tdav260/NotSoSmartWatch/Hardware/Basic/Bottom/NotSoSmartWatch-BASIC-BOTTOM-BOM.xlsx

NotSoSmartWatch Bottom Board -- Rev A / Thomas Davis |  |  |  |  |  |  |  |  |  |  | Total | $20.04 | Total (in Bulk) | $0.00
BOM # | Comment | Designator | Description | Mounting Type | Package | Manufacturer | Manufacturer Part Number | Supplier | Supplier Part Number | Price per unit | Quantity | Total | Per 100 | Total
 | DigiKey
1 | Real-Time Clock | RTC | Real Time Clock (RTC) IC Clock/Calendar I²C, 2-Wire Serial 8-SOIC (0.154", 3.90mm Width) | SMD | 8-SO | NXP USA Inc. | PCF8523T/1,118 | Digi-Key | 568-5306-1-ND | $1.26 | 1 | $1.26
2 | 32.768 kHz Crystal | XTAL2 | 32.768kHz ±10ppm Crystal 12.5pF 90 kOhms 2-SMD, No Lead | SMD | 2-SMD, No Lead | ECS Inc. | ECS-.327-12.5-12-C-TR | Digi-Key | XC2288CT-ND | $0.60 | 1 | $0.60
3 | AD5242 | U1 | Digital Potentiometer 1M Ohm 2 Circuit 256 Taps I²C Interface 16-SOIC | SMD | 16-SOIC | Analog Devices Inc. | AD5242BRZ1M | Digi-Key | AD5242BRZ1M-ND | $3.47 | 1 | $3.47
4 | CONN_07-1.27MM (CONN_07) | J1 | 50 Position Header Connector 0.050" (1.27mm) Through Hole Gold | THT |  | Sullins Connector Solutions | LPPB501NFFN-RC | Digi-Key | S9008E-50-ND | $5.06 | 1 | $5.06
5 | NPN-Generic | Q1 | Bipolar (BJT) Transistor NPN 40V 600mA 300MHz 250mW Surface Mount TO-236AB | SMD | TO-236AB | Nexperia USA Inc. | PMBT2222A,215 | Digi-Key | 1727-2956-1-ND | $1.05 | 1 | $1.05
6 | 100 nF Capacitor | C1, C2, C10, C11, C17, C18, C22 | 0.1µF ±5% 16V Ceramic Capacitor X7R 0603 (1608 Metric) | SMD | 0603 | Yageo | CC0603JRX7R7BB104 | Digi-Key | 311-1776-1-ND | $0.03 | 7 | $0.23
7 | 10k ohm Resistor | R17, R18, R24 | 10 kOhms ±1% 0.1W, 1/10W Chip Resistor 0603 (1608 Metric) Automotive AEC-Q200 Thick Film | SMD | 0603 | Stackpole Electronics Inc | RMCF0603FT10K0 | Digi-Key | RMCF0603FT10K0CT-ND | $0.01 | 3 | $0.02
8 | 1 uF Capacitor | C3 | 1µF ±10% 25V Ceramic Capacitor X5R 0603 (1608 Metric) | SMD | 0603 | Samsung Electro-Mechanics | CL10A105KA8NNNC | Digi-Key | 1276-1102-1-ND | $0.10 | 1 | $0.10
9 | CONN_07-1.27MM | G$1 | 50 Positions Header Connector 0.050" (1.27mm) Through Hole Gold | THT |  | Sullins Connector Solutions | GRPB501VWVN-RC | Digi-Key | S9014E-50-ND | $3.11 | 1 | $3.11
10 | 2.2 uF Capacitor | C14, C15, C16, C19 | 2.2µF ±10% 16V Ceramic Capacitor X5R 0603 (1608 Metric) | SMD | 0603 | Samsung Electro-Mechanics | CL10A225KO8NNNC | Digi-Key | 1276-1040-1-ND | $0.03 | 4 | $0.13
11 | 220k ohm Resistor | R13, R15, R19, R21 | 220 kOhms ±1% 0.1W, 1/10W Chip Resistor 0603 (1608 Metric) Automotive AEC-Q200 Thick Film | SMD | 0603 | Stackpole Electronics Inc | RMCF0603FT220K | Digi-Key | RMCF0603FT220KCT-ND | $0.01 | 4 | $0.02
12 | 10M ohm Resistor | R14, R22 | 10 MOhms ±1% 0.1W, 1/10W Chip Resistor 0603 (1608 Metric) Automotive AEC-Q200 Thick Film | SMD | 0603 | Stackpole Electronics Inc | RMCF0603FT10M0 | Digi-Key | RMCF0603FT10M0CT-ND | $0.01 | 2 | $0.02
13 | 1M ohm Resistor | R20, R23 | 1 MOhms ±1% 0.1W, 1/10W Chip Resistor 0603 (1608 Metric) Automotive AEC-Q200 Thick Film | SMD | 0603 | Stackpole Electronics Inc | RMCF0603FT1M00 | Digi-Key | RMCF0603FT1M00CT-ND | $0.01 | 2 | $0.01
14 | 22 uF Capacitor | C20 | 22µF ±20% 10V Ceramic Capacitor X5R 0603 (1608 Metric) | SMD | 0603 | Samsung Electro-Mechanics | CL10A226MP8NUNE | Digi-Key | 1276-1274-1-ND | $0.07 | 1 | $0.07
15 | 22 nF Capacitor | C21 | 0.022µF ±10% 50V Ceramic Capacitor X7R 0603 (1608 Metric) | SMD | 0603 | Samsung Electro-Mechanics | CL10B223KB8NNNC | Digi-Key | 1276-1104-1-ND | $0.02 | 1 | $0.02
16 | Op Amp | OP3$G1, OP3$G2, OP3$G3, OP3$G4, OP4$G1 | General Purpose Amplifier 4 Circuit Rail-to-Rail 14-SOIC | SMD | 14-SOIC | Microchip Technology | MCP6004T-I/SL | Digi-Key | MCP6004T-I/SLCT-ND | $0.44 | 5 | $2.20
 | Mouser
1 | AD5171 | U$4 | Digital Potentiometer ICs IC 6-Bit OTP I2C | SMD | SOT-23-8 | Analog Devices | AD5171BRJZ100-R7 | Mouser | 584-AD5171BRJZ100-R7 | $2.68 | 1 | $2.68 |  | $0.00
 | Custom Order
1 | LSM6DS3 castellated breakout | IMU1 |  |  |  |  |  |  |  |  |  | $0.00
