tdav260/NotSoSmartWatch/Hardware/Basic/Top/NotSoSmartWatch-BASIC-TOP-BOM.xlsx

NotSoSmartWatch Top Board -- Rev A / Thomas Davis |  |  |  |  |  |  |  |  |  |  | Total | $29.83 | Total (in Bulk) | $0.00
BOM # | Comment | Designator | Description | Mounting Type | Package | Manufacturer | Manufacturer Part Number | Supplier | Supplier Part Number | Price per unit | Quantity | Total | Per 100 | Total
 | DigiKey
1 | Microcontroller | U1 | Bluetooth Bluetooth v4.2 Transceiver Module 2.4GHz Integrated, Chip Surface Mount | SMD | 41-SMD Module | Seeed Technology Co., Ltd | 317030213 | Digi-Key | 1597-1434-ND | $10.10 | 1 | $10.10
2 | FTDI | FTDI | USB Bridge, USB to UART USB 2.0 UART Interface 20-SSOP | SMD | 20-SSOP | FTDI, Future Technology Devices International Ltd | FT231XS-U | Digi-Key | 768-1156-5-ND | $2.12 | 1 | $2.12
3 | USB Interface | USB1 | USB - micro B USB 2.0 Receptacle Connector 5 Position Surface Mount, Right Angle | SMD | Flange, Horizontal | Amphenol FCI | 10118192-0001LF | Digi-Key | 609-4613-1-ND | $0.43 | 1 | $0.43
4 | Battery Charger | CHRG | Charger IC Lithium-Ion/Polymer SOT-23-5 | SMD | SOT-23-5 | Microchip Technology | MCP73831T-2ACI/OT | Digi-Key | MCP73831T-2ACI/OTCT-ND | $0.56 | 1 | $0.56
5 | Voltage Regulator | LDO1 | Linear Voltage Regulator IC 1 Output 300mA SOT-23-5 | SMD | SOT23-5 | Microchip Technology | MIC5504-3.3YM5-TR | Digi-Key | 576-4764-1-ND | $0.11 | 1 | $0.11
6 | Bigger Button | SW3, SW4 | Tactile Switch SPST-NO Top Actuated Surface Mount | SMD | Gull Wing | C&K | PTS645SM43SMTR92 LFS | Digi-Key | CKN9112CT-ND | $0.25 | 2 | $0.50
7 | 390k ohm resistor | R15 | 390 kOhms ±1% 0.1W, 1/10W Chip Resistor 0603 (1608 Metric) Automotive AEC-Q200 Thick Film | SMD | 0603 | Stackpole Electronics Inc | RMCF0603FG390K | Digi-Key | RMCF0603FG390KCT-ND | $0.01 | 1 | $0.01
8 | Schottky Diode | D1, D2, D3 | Diode Schottky 30V 1.5A Surface Mount USC | SMD | USC | Toshiba Semiconductor and Storage | CUS15S30,H3F | Digi-Key | CUS15S30H3FCT-ND | $0.26 | 3 | $0.77
9 | 100 nF Capacitor | C11, C14 | 0.1µF ±5% 16V Ceramic Capacitor X7R 0603 (1608 Metric) | SMD | 0603 | Yageo | CC0603JRX7R7BB104 | Digi-Key | 311-1776-1-ND | $0.03 | 2 | $0.07
10 | 10k ohm Resistor | R1, R2, R6, R10, R13 | 10 kOhms ±1% 0.1W, 1/10W Chip Resistor 0603 (1608 Metric) Automotive AEC-Q200 Thick Film | SMD | 0603 | Stackpole Electronics Inc | RMCF0603FT10K0 | Digi-Key | RMCF0603FT10K0CT-ND | $0.01 | 5 | $0.03
11 | 2.2u capacitor | C16, C17, C18, C19, C20 | 2.2µF ±10% 16V Ceramic Capacitor X5R 0603 (1608 Metric) | SMD | 0603 | Samsung Electro-Mechanics | CL10A225KO8NNNC | Digi-Key | 1276-1040-1-ND | $0.03 | 5 | $0.16
12 | 10 uF 0603 Capacitor | C2, C15 | 10µF ±10% 10V Ceramic Capacitor X5R 0603 (1608 Metric) | SMD | 0603 | Murata Electronics | GRM188R61A106KE69J | Digi-Key | 490-14372-1-ND | $0.06 | 2 | $0.13
13 | 47 pF Capacitor | C12, C13 | 47pF ±5% 50V Ceramic Capacitor C0G, NP0 0603 (1608 Metric) | SMD | 0603 | Walsin Technology Corporation | 0603N470J500CT | Digi-Key | 1292-1528-1-ND | $0.01 | 2 | $0.02
14 | 27 ohm resistor | R11, R12 | 27 Ohms ±1% 0.1W, 1/10W Chip Resistor 0603 (1608 Metric) Automotive AEC-Q200 Thick Film | SMD | 0603 | Stackpole Electronics Inc | RMCF0603FT27R0 | Digi-Key | RMCF0603FT27R0CT-ND | $0.01 | 2 | $0.01
15 | 1k ohm Resistor | R4, R5, R14, R16 | 1 kOhms ±1% 0.1W, 1/10W Chip Resistor 0603 (1608 Metric) Automotive AEC-Q200 Thick Film | SMD | 0603 | Stackpole Electronics Inc | RMCF0603FT1K00 | Digi-Key | RMCF0603FT1K00CT-ND | $0.01 | 4 | $0.02
16 | Red LED | LED1, LED3 | Red 622nm LED Indication - Discrete 2.2V 0603 (1608 Metric) | SMD | 0603 | Inolux | IN-S63ATR | Digi-Key | 1830-1065-1-ND | $0.18 | 2 | $0.35
17 | Yellow LED | LED4 | Yellow 590nm LED Indication - Discrete 2V 0603 (1608 Metric) | SMD | 0603 | Wurth Electronics Inc. | 150060YS75000 | Digi-Key | 732-4981-1-ND | $0.14 | 1 | $0.14
18 | Blue LED | LED2 | Blue 470nm LED Indication - Discrete 3V 0603 (1608 Metric) | SMD | 0603 | Inolux | IN-S63AT5B | Digi-Key | 1830-1061-1-ND | $0.18 | 1 | $0.18
19 | 32.768 kHz Crystal | XTAL1 | 32.768kHz ±10ppm Crystal 12.5pF 90 kOhms 2-SMD, No Lead | SMD | 2-SMD, No Lead | ECS Inc. | ECS-.327-12.5-12-C-TR | Digi-Key | XC2288CT-ND | $0.60 | 1 | $0.60
20 | 12 pF Capacitor | C3, C4 | 12pF ±5% 50V Ceramic Capacitor C0G, NP0 0603 (1608 Metric) | SMD | 0603 | Walsin Technology Corporation | 0603N120J500CT | Digi-Key | 1292-1480-1-ND | $0.01 | 2 | $0.02
21 | Debugger | DEBUG1 | Connector Header Through Hole 10 position 0.050" (1.27mm) | THT | NA | Amphenol ICC (FCI) | 20021111-00010T4LF | Digi-Key | 609-3712-ND | $0.69 | 1 | $0.69
22 | 1 uF Capacitor | C1, C8, C9 | 1µF ±10% 25V Ceramic Capacitor X5R 0603 (1608 Metric) | SMD | 0603 | Samsung Electro-Mechanics | CL10A105KA8NNNC | Digi-Key | 1276-1102-1-ND | $0.10 | 3 | $0.30
23 | 10 uH Inductor | L1 | 10µH Shielded Multilayer Inductor 250mA 1.05Ohm 0603 (1608 Metric) | SMD | 0603 | TDK Corporation | MLZ1608M100WTD25 | Digi-Key | MLZ1608M100WTD25 | $0.22 | 1 | $0.22
24 | 4.7 uF Capacitor | C5, C7 | 4.7 uF ±10% 16V Ceramic Capacitor X5R 0603 (1608 Metric) | SMD | 0603 | Samsung Electro-Mechanics | CL10A475KO8NNNC | Digi-Key | 1276-1784-1-ND | $0.04 | 2 | $0.09
25 | 100k ohm Resistor | R3, R7, R8, R9 | 100 kOhms ±1% 0.1W, 1/10W Chip Resistor 0603 (1608 Metric) Automotive AEC-Q200 Thick Film | SMD | 0603 | Stackpole Electronics Inc | RMCF0603FT100K | Digi-Key | RMCF0603FT100KCT-ND | $0.01 | 4 | $0.02
26 | CONN_07-1.27MM (CONN_07) | J1 | 50 Position Header Connector 0.050" (1.27mm) Through Hole Gold | THT |  | Sullins Connector Solutions | LPPB501NFFN-RC | Digi-Key | S9008E-50-ND | $5.06 | 1 | $5.06
27 | Tiny Rectangular Switch | SW1, RESET | Tactile Switch SPST-NO Top Actuated Surface Mount | SMD | Gull Wing | C&K Components | PTS830GM140 SMTR LFS | Digi-Key | CKN10587CT-ND | $0.57 | 2 | $1.14
28 | 350 mAh LiPo Battery | J2 | 3.7V Lithium Polymer Battery Rechargeable (Secondary) 350mAh | JST | JST PH Connector | Adafruit Industries LLC | 4237 | Digi-Key | 1528-4237-ND | $5.95 | 1 | $5.95
29 | 0 ohm resistor (not sure if needed) | JP1, R17, R18 | 0 Ohms Jumper 0.1W, 1/10W Chip Resistor 0603 (1608 Metric) Moisture Resistant Thick Film | SMD | 603 | Yageo | RC0603JR-070RL | Digi-Key | 311-0.0GRCT-ND | $0.01 | 3 | $0.03
 | BuyDisplay.com
29 | OLED | U4 | Datasheet 128x64 OLED Module SPI 0.96"Graphic Displays,White on Black | SMD | Flexible Connector | EastRising | https://www.buydisplay.com/datasheet-128x64-oled-module-spi-0-96-inch-graphic-displays-white-on-black | BuyDisplay.com | https://www.buydisplay.com/datasheet-128x64-oled-module-spi-0-96-inch-graphic-displays-white-on-black | $2.51
