tdav260/NotSoSmartWatch/Hardware/Basic/PPG-Module/NotSoSmartWatch-BASIC-PPG-MODULE-BOM.xlsx

NotSoSmartWatch PPG Module -- Rev A / Thomas Davis |  |  |  |  |  |  |  |  |  |  | Total | $4.79 | Total (in Bulk) | $3.25
BOM # | Comment | Designator | Description | Mounting Type | Package | Manufacturer | Manufacturer Part Number | Supplier | Supplier Part Number | Price per unit | Quantity | Total | Per 100 | Total
1 | Photodiode | PD | Photodiode 940nm 100ns 130° 2-SMD, Gull Wing, PHOTODIODE PIN HI SPEED HI SENS | SMD | 2-SMD, Gull Wing | Vishay Semiconductor Opto Division | VBPW34S | Digi-Key | 751-1500-1-ND | $1.19 | 1 | $1.19 | $0.57 | $0.57
2 | Green LED | LED1 | Green 525nm LED Indication - Discrete 3.1V 0805 (2012 Metric) | SMD | 0805 | QT Brightek (QTB) | QBLP631-IG | Digi-Key | 1516-1084-1-ND | $0.39 | 1 | $0.39 | $0.16 | $0.16
3 | 2.2µF capacitor | 0603 | 2.2µF ±10% 10V Ceramic Capacitor X5R 0603 (1608 Metric) | SMD | 0603 | Samsung Electro-Mechanics | CL10A225KP8NNNC | Digi-Key | 1276-1085-1-ND | $0.10 | 1 | $0.10 | $0.03 | $0.03
4 | 0.05' spaced Header Pins | J1 | Connector Header Through Hole 50 position 0.050" (1.27mm) | THT | NA | Sullins Connector Solutions | GRPB501VWVN-RC | Digi-Key | S9014E-50-ND | $3.11 | 1 | $3.11 | $2.49 | $2.49
