tdav260/NotSoSmartWatch/Hardware/Basic/Top/NotSoSmartWatch-BASIC-TOP-version2.brd

## EAGLE design Hardware/Basic/Top/NotSoSmartWatch-BASIC-TOP-version2.brd (2021-03-20)

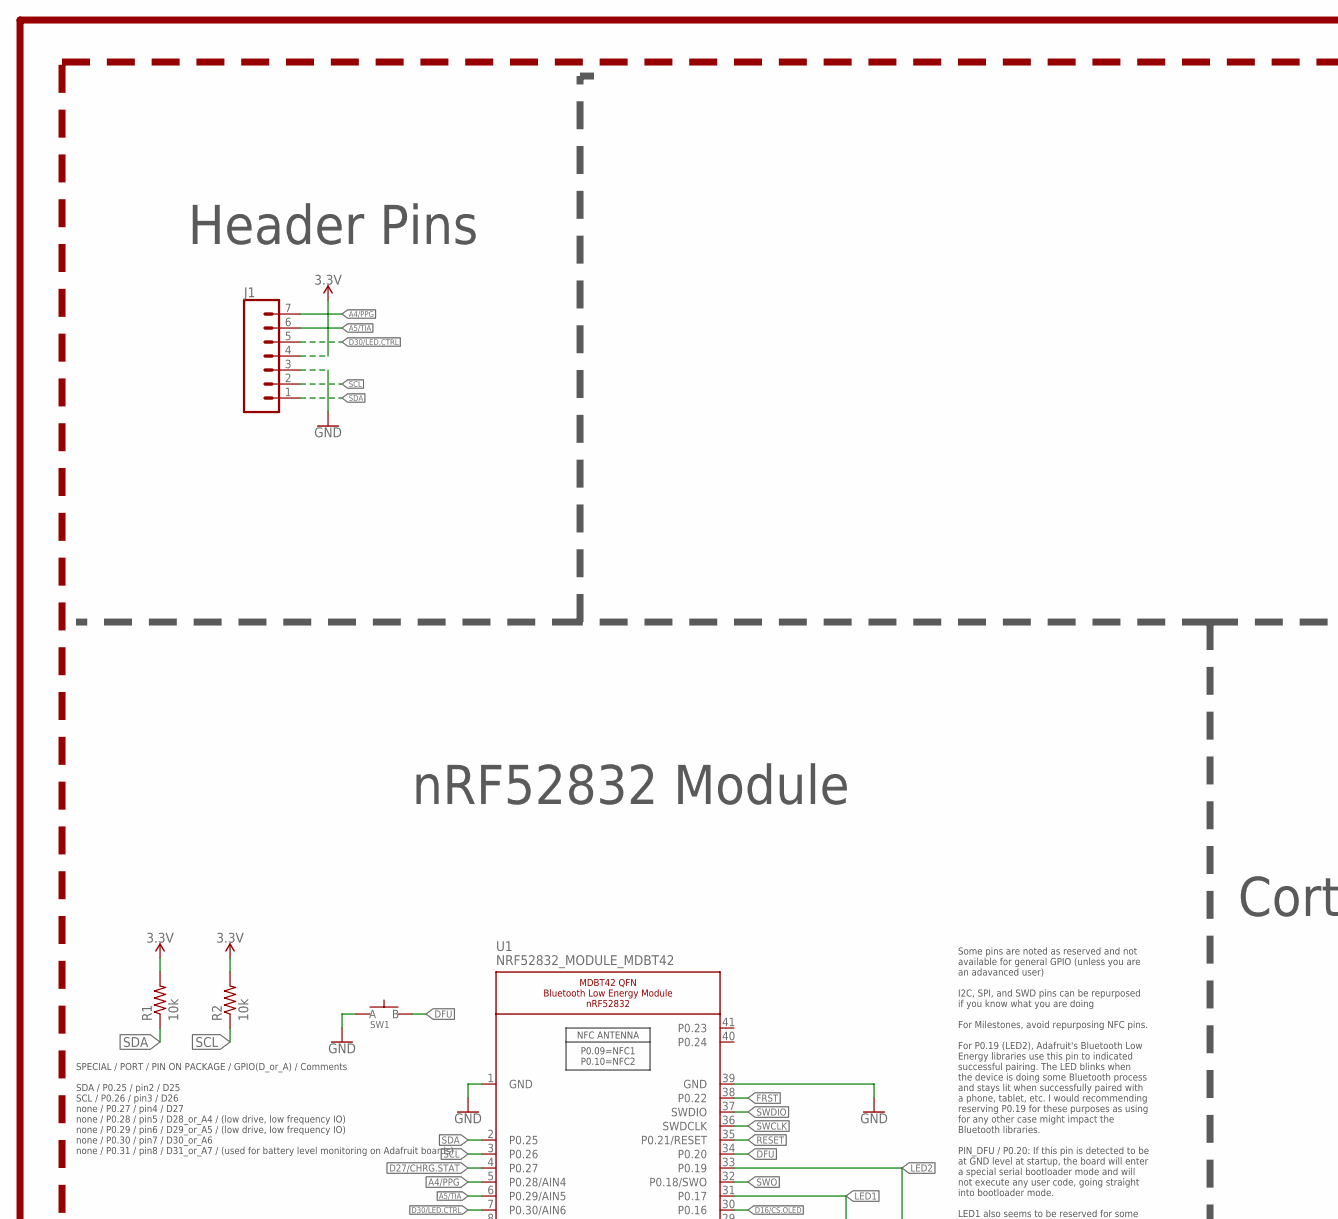
[picture p1: schematic NotSoSmartWatch-BASIC-TOP-version2.sch, part in row 1, column 1]

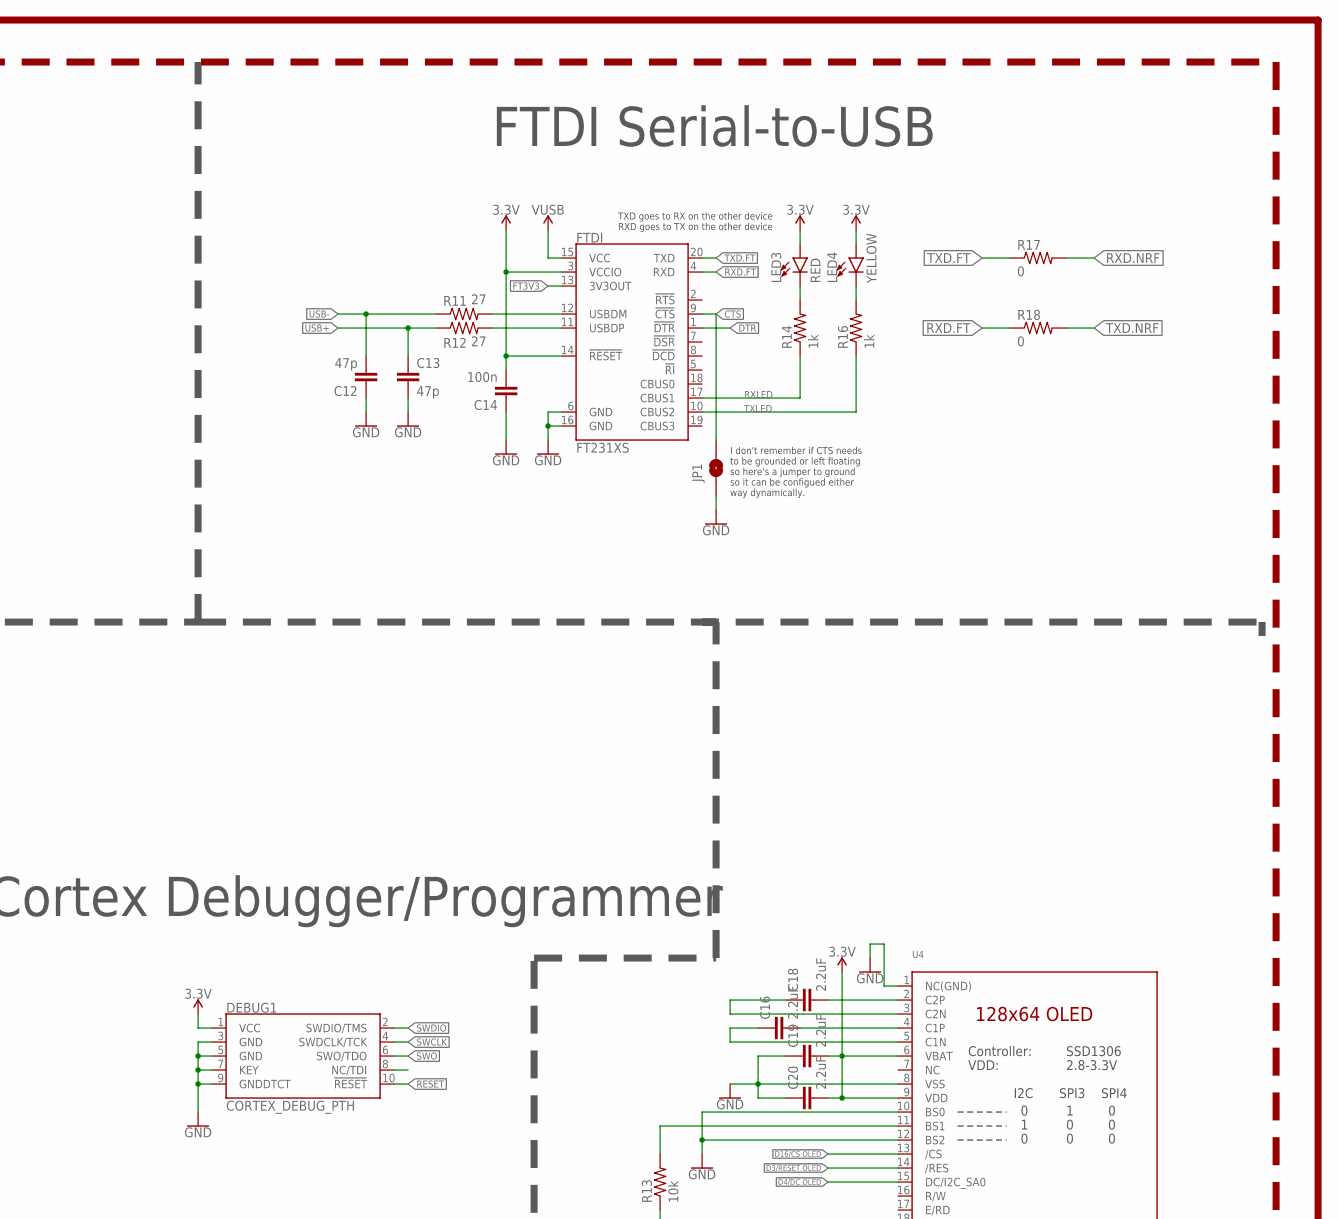
[picture p2: schematic NotSoSmartWatch-BASIC-TOP-version2.sch, part in row 1, column 2]

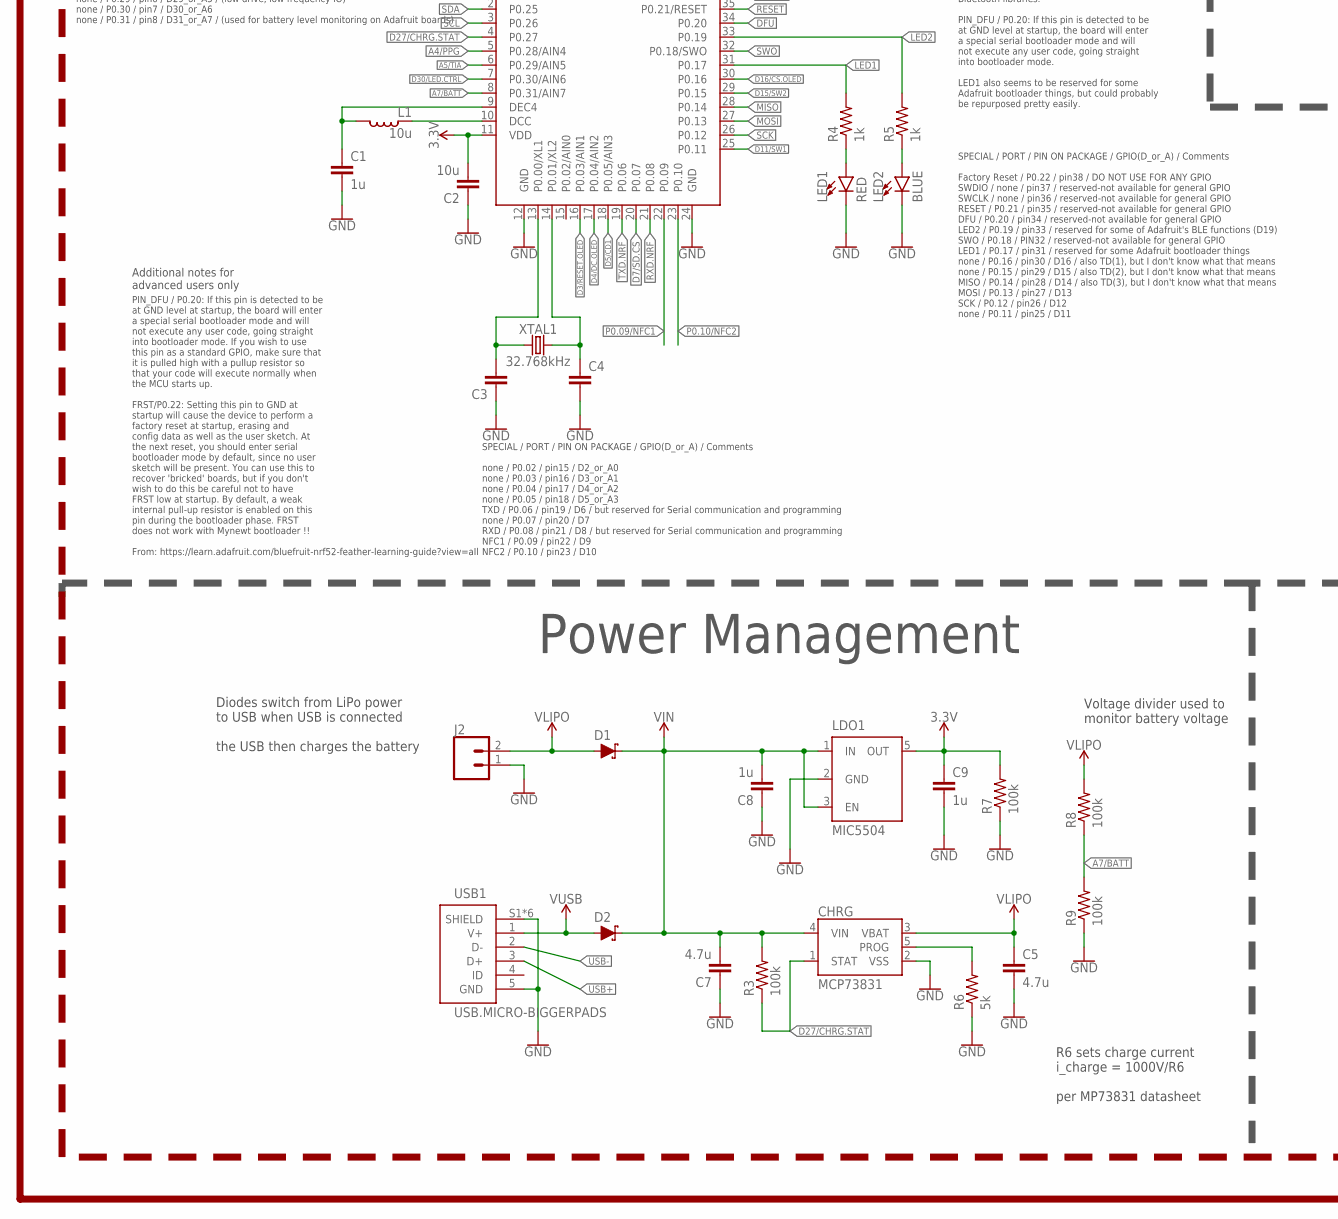
[picture p3: schematic NotSoSmartWatch-BASIC-TOP-version2.sch, part in row 2, column 1]

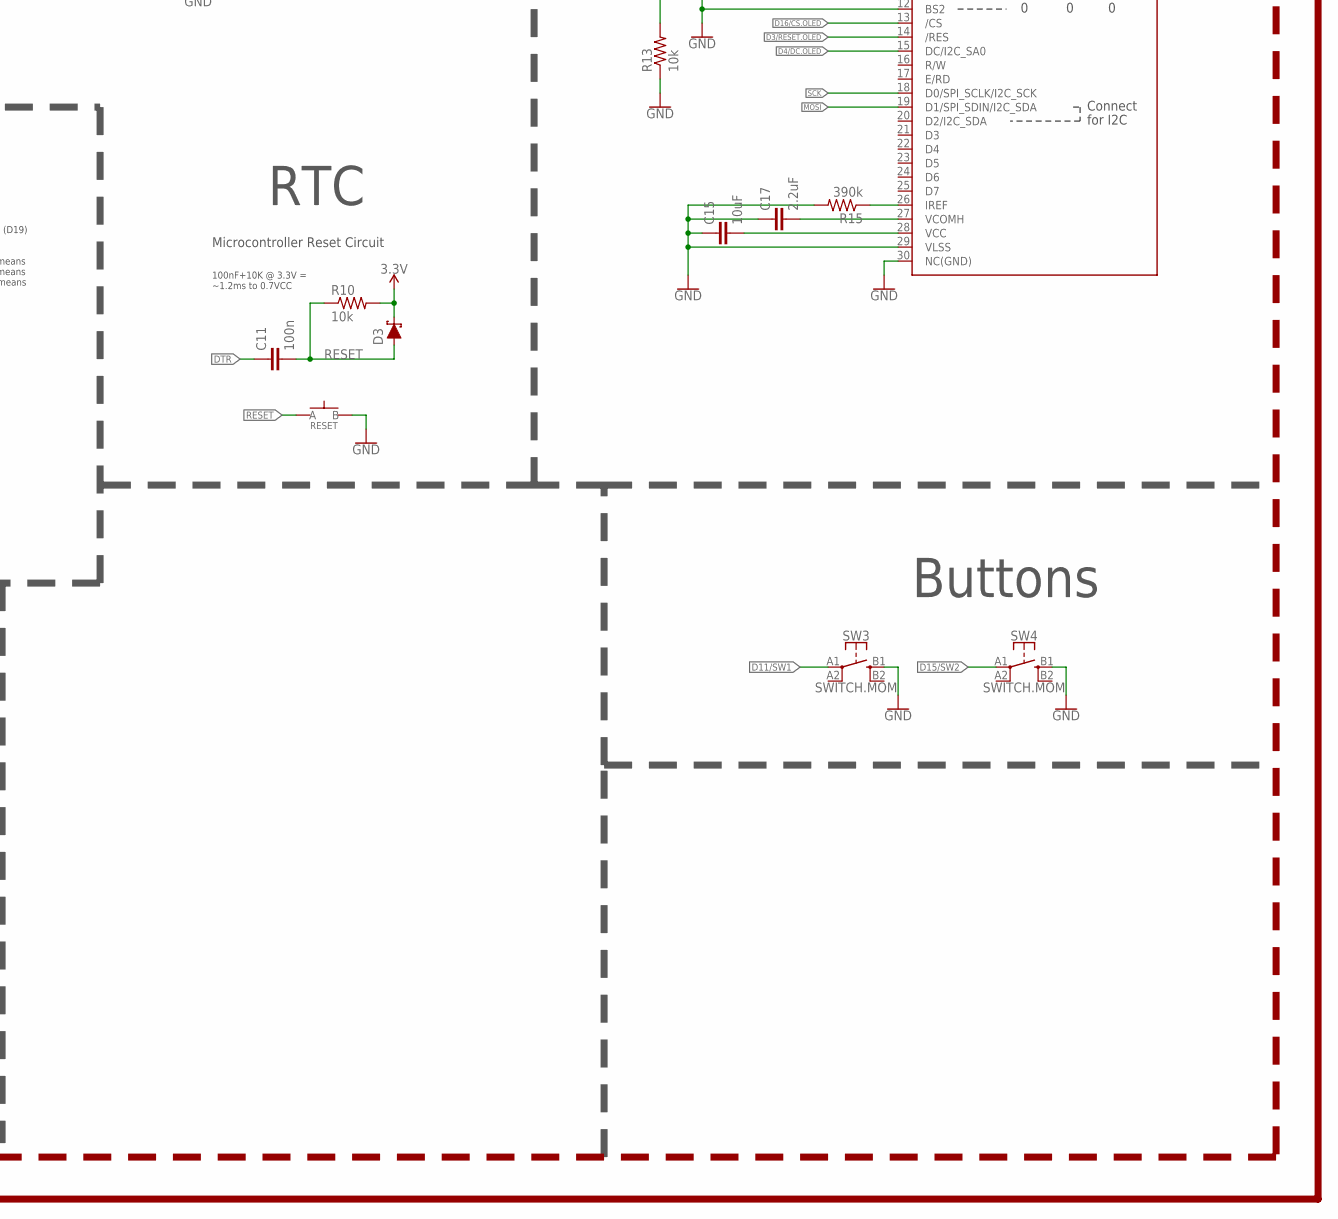
[picture p4: schematic NotSoSmartWatch-BASIC-TOP-version2.sch, part in row 2, column 2]

Parts:
C1, C8, C9: 1u; C0603
C2: 10u; C0805
C3, C4: CAPACITOR0603; C0603
C5, C7: 4.7u; C0603
C11, C14: 100n; C0603
C12, C13: 47p; C0603
C15: 10uF; C0603
C16, C18, C19, C20: 2.2uF; C0402
C17: 2.2uF; C0603
CHRG: MCP73831; SOT23-5
D1, D2, D3: SCHOTTKY-USC; USC
DEBUG1: CORTEX_DEBUG_PTH; 2X5-PTH-1.27MM
FTDI: FT231XS; SSOP20_L
J1: CONN_07-1.27MM; 1X07_1.27MM
J2: CONN_02; 1X02
JP1: JUMPER-SMT_2_NO_SILK; SMT-JUMPER_2_NO_SILK
L1: 10u; L0603
LDO1: MIC5504; SOT23-5
LED1, LED3: RED; LED-0603
LED2: BLUE; LED-0603
LED4: YELLOW; LED-0603
R1, R2, R10, R13: 10k; R0603
R3, R7, R8, R9: 100k; R0603
R4, R5, R14, R16: 1k; R0603
R6: 5k; R0603
R11, R12: 27; R0603
R15: 390k; R0603
R17, R18: 0; R0603
RESET: SPST-PTS830GG140-COPY.1-3; BUTTON-GULLWING
SW1: SPST-PTS830GG140-COPY.1-3; BUTTON-GULLWING
SW3, SW4: SWITCH.MOM; TACTILE_SWITCH_SMD_6.2MM_TALL
U1: NRF52832_MODULE_MDBT42; BLE_MODULE_RAYTAC_MDBT42
U4: DISP_OLED_UG-2864HSWEG01-NO-WRAPAROUND; UG-2864HSWEG01_0.96IN_NO-WRAPAROUND
USB1: USB.MICRO-BIGGERPADS; USB-MICRO-01.BIGGERPADS
XTAL1: 32.768kHz; 2-SMD.NOLEAD.2.0MMTO1.2MM

Connections:
3.3V: C2.2, C9.1, C14.2, C19.2, C20.2, D3.- (C), DEBUG1.1 (VCC), FTDI.3 (VCCIO), FTDI.14 (!RESET), J1.4, LDO1.5 (OUT), LED3.A, LED4.A, R1.2, R2.2, R7.2, R10.2, U1.11 (VDD), U4.6 (VBAT), U4.9 (VDD)
A4/PPG: J1.7, U1.5 (P0.28/AIN4)
A5/TIA: J1.6, U1.6 (P0.29/AIN5)
A7/BATT: R8.1, R9.2, U1.8 (P0.31/AIN7)
CTS: FTDI.9 (!CTS), JP1.2
D3/RESET.OLED: U1.16 (P0.03/AIN1), U4.14 (/RES)
D4/DC.OLED: U1.17 (P0.04/AIN2), U4.15 (DC/I2C_SA0)
D5/CD1: U1.18 (P0.05/AIN3)
D7/SD.CS: U1.20 (P0.07)
D11/SW1: SW3.A1 (1), U1.25 (P0.11)
D15/SW2: SW4.A1 (1), U1.29 (P0.15)
D16/CS.OLED: U1.30 (P0.16), U4.13 (/CS)
D27/CHRG.STAT: CHRG.1 (STAT), R3.1, U1.4 (P0.27)
D30/LED.CTRL: J1.5, U1.7 (P0.30/AIN6)
DFU: SW1.3 (B), U1.34 (P0.20)
DTR: C11.1, FTDI.1 (!DTR)
FRST: U1.38 (P0.22)
FT3V3: FTDI.13 (3V3OUT)
GND: C1.2, C2.1, C3.1, C4.2, C5.2, C7.1, C8.1, C9.2, C12.1, C13.2, C14.1, C15.1, C17.1, C19.1, C20.1, CHRG.2 (VSS), DEBUG1.3 (GND), DEBUG1.5 (GND), DEBUG1.7 (KEY), DEBUG1.9 (GNDDTCT), FTDI.6 (GND), FTDI.16 (GND), J1.3, J2.1, JP1.1, LDO1.2 (GND), LED1.C, LED2.C, R6.1, R7.1, R9.1, R13.1, R15.2, RESET.3 (B), SW1.1 (A), SW3.B1 (3), SW4.B1 (3), U1.1 (GND), U1.12 (GND), U1.24 (GND), U1.39 (GND), U4.1 (NC(GND)), U4.8 (VSS), U4.10 (BS0), U4.12 (BS2), U4.29 (VLSS), U4.30 (NC(GND)), USB1.5 (GND), USB1.S1 (SHIELD), USB1.S2 (SHIELD), USB1.S3 (SHIELD), USB1.S4 (SHIELD), USB1.S5 (SHIELD), USB1.S6 (SHIELD)
LED1: R4.2, U1.31 (P0.17)
LED2: R5.2, U1.33 (P0.19)
MISO: U1.28 (P0.14)
MOSI: U1.27 (P0.13), U4.19 (D1/SPI_SDIN/I2C_SDA)
unnamed: R13.2, U4.11 (BS1)
unnamed: R15.1, U4.26 (IREF)
unnamed: C18.2, U4.2 (C2P)
unnamed: C3.2, U1.13 (P0.00/XL1), XTAL1.P$1 (1)
unnamed: C18.1, U4.3 (C2N)
unnamed: C4.1, U1.14 (P0.01/XL2), XTAL1.P$2 (2)
unnamed: C16.2, U4.4 (C1P)
unnamed: C16.1, U4.5 (C1N)
unnamed: LED1.A, R4.1
unnamed: LED2.A, R5.1
unnamed: L1.1, U1.10 (DCC)
unnamed: C1.1, L1.2, U1.9 (DEC4)
unnamed: C15.2, U4.28 (VCC)
unnamed: C17.2, U4.27 (VCOMH)
unnamed: CHRG.5 (PROG), R6.2
unnamed: FTDI.12 (USBDM), R11.2
unnamed: FTDI.11 (USBDP), R12.2
unnamed: LED3.C, R14.2
unnamed: LED4.C, R16.2
P0.09/NFC1: U1.22 (P0.09)
P0.10/NFC2: U1.23 (P0.10)
RESET: C11.2, D3.+ (A), DEBUG1.10 (!RESET), R10.1, RESET.1 (A), U1.35 (P0.21/RESET)
RXD.FT: FTDI.4 (RXD), R18.1
RXD.NRF: R17.2, U1.21 (P0.08)
RXLED: FTDI.17 (CBUS1), R14.1
SCK: U1.26 (P0.12), U4.18 (D0/SPI_SCLK/I2C_SCK)
SCL: J1.2, R2.1, U1.3 (P0.26)
SDA: J1.1, R1.1, U1.2 (P0.25)
SWCLK: DEBUG1.4 (SWDCLK/TCK), U1.36 (SWDCLK)
SWDIO: DEBUG1.2 (SWDIO/TMS), U1.37 (SWDIO)
SWO: DEBUG1.6 (SWO/TDO), U1.32 (P0.18/SWO)
TXD.FT: FTDI.20 (TXD), R17.1
TXD.NRF: R18.2, U1.19 (P0.06)
TXLED: FTDI.10 (CBUS2), R16.1
USB+: C13.1, R12.1, USB1.3 (D+)
USB-: C12.2, R11.1, USB1.2 (D-)
VIN: C7.2, C8.2, CHRG.4 (VIN), D1.- (C), D2.- (C), LDO1.1 (IN), LDO1.3 (EN), R3.2
VLIPO: C5.1, CHRG.3 (VBAT), D1.+ (A), J2.2, R8.2
V_USB: D2.+ (A), FTDI.15 (VCC), USB1.1 (V+)

Notes on the sheet:
Microcontroller Reset Circuit
100nF+10K @ 3.3V = ~1.2ms to 0.7VCC
SPECIAL / PORT / PIN ON PACKAGE / GPIO(D_or_A) / Comments SDA / P0.25 / pin2 / D25 SCL / P0.26 / pin3 / D26 none / P0.27 / pin4 / D27 none / P0.28 / pin5 / D28_or_A4 / (low drive, low frequency IO) none / P0.29 / pin6 / D29_or_A5 / (low drive, low frequency IO) none / P0.30 / pin7 / D30_or_A6 none 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
SPECIAL / PORT / PIN ON PACKAGE / GPIO(D_or_A) / Comments none / P0.02 / pin15 / D2_or_A0 none / P0.03 / pin16 / D3_or_A1 none / P0.04 / pin17 / D4_or_A2 none / P0.05 / pin18 / D5_or_A3 TXD / P0.06 / pin19 / D6 / but reserved for Serial communication and programming none / P0.07 / pin20 / D7 RXD / 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
SPECIAL / PORT / PIN ON PACKAGE / GPIO(D_or_A) / Comments Factory Reset / P0.22 / pin38 / DO NOT USE FOR ANY GPIO SWDIO / none / pin37 / reserved-not available for general GPIO SWCLK / none / pin36 / reserved-not available for general GPIO RESET / P0.21 / pin35 / reserved-not available for general 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
Some pins are noted as reserved and not available for general GPIO (unless you are an adavanced user) I2C, SPI, and SWD pins can be repurposed if you know what you are doing For Milestones, avoid repurposing NFC pins. For P0.19 (LED2), Adafruit's Bluetooth Low Energy libraries use this pin to indic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
PIN_DFU / P0.20: If this pin is detected to be at GND level at startup, the board will enter a special serial bootloader mode and will not execute any user code, going straight into bootloader mode. If you wish to use this pin as a standard GPIO, make sure that it is pulled high with a pullup resis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
Additional notes for advanced users only
nRF52832 Module
Power Management
Buttons
Cortex Debugger/Programmer
RTC
TXD goes to RX on the other device RXD goes to TX on the other device
I don't remember if CTS needs to be grounded or left floating so here's a jumper to ground so it can be configued either way dynamically.
FTDI Serial-to-USB
Header Pins
Diodes switch from LiPo power to USB when USB is connected the USB then charges the battery
R6 sets charge current i_charge = 1000V/R6 per MP73831 datasheet
Voltage divider used to monitor battery voltage

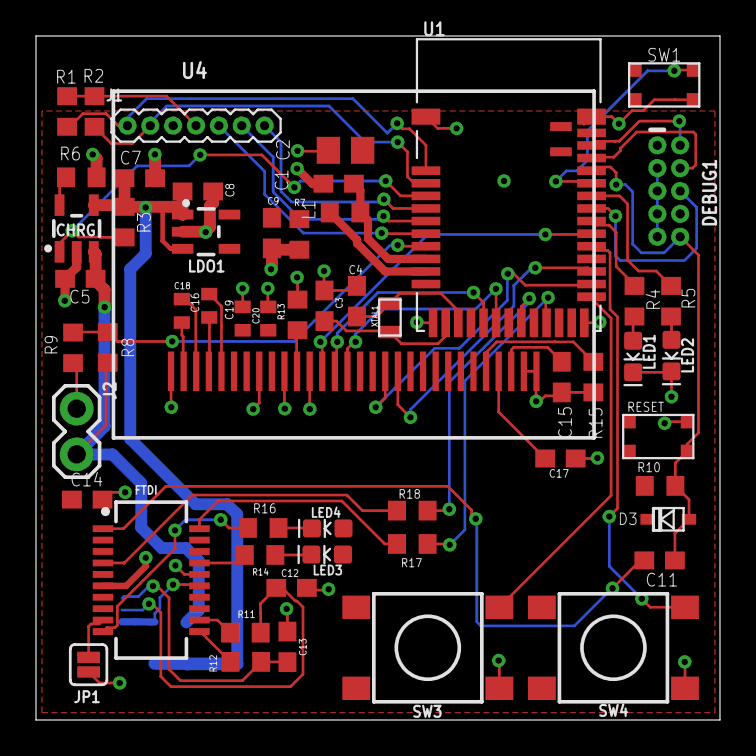
[picture p5: board NotSoSmartWatch-BASIC-TOP-version2.brd from above]

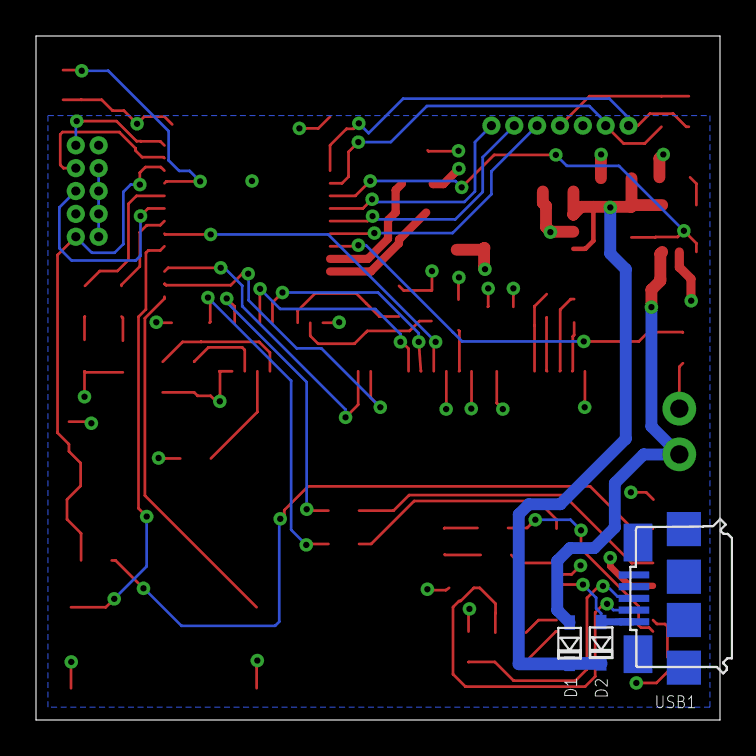
[picture p6: board NotSoSmartWatch-BASIC-TOP-version2.brd from below]

Board: 2 copper layers, 38.0 x 38.0 mm, 59 parts (3 on the bottom side), 55 nets.
