tdav260/NotSoSmartWatch/Hardware/Basic/PPG-Module/NotSoSmartWatch-BASIC-PPG-MODULE.brd

## EAGLE design Hardware/Basic/PPG-Module/NotSoSmartWatch-BASIC-PPG-MODULE.brd (2021-03-20)



Board: 2 copper layers, 12.4 x 12.4 mm, 5 parts (3 on the bottom side), 4 nets.

Parts:
C1: 2.2u; C0603
J1: PPG.MODULE.2
LED1: LED-0805
PD: 2-SMD.GULLWING
U$3: LINNES.LAB.LOGO

Connections:
GND: C1.2, J1.GND, PD.+
LED.C: J1.LD1, LED1.C
PD.C: J1.PD, PD.-
V+: C1.1, J1.V+, LED1.A
