tdav260/NotSoSmartWatch/(commit log)

2021-02-13 Arduino code
2021-02-13 basic bottom BOM
    [NotSoSmartWatch-BASIC-BOTTOM-BOM.xlsx]
2021-02-13 basic bottom EAGLE board
    [NotSoSmartWatch-BASIC-BOTTOM.brd]
2021-02-13 basic bottom EAGLE schematic
    [NotSoSmartWatch-BASIC-BOTTOM.sch]
2021-02-13 basic top BOM
    [NotSoSmartWatch-BASIC-TOP-BOM.xlsx]
2021-02-13 basic top EAGLE board
    [NotSoSmartWatch-BASIC-TOP.brd]
2021-02-13 basic top EAGLE schematic
    [NotSoSmartWatch-BASIC-TOP.sch]
2021-02-13 basic PPG module BOM
    [NotSoSmartWatch-BASIC-PPG-MODULE-BOM.xlsx]
2021-02-13 basic PPG module EAGLE board
    [NotSoSmartWatch-BASIC-PPG-MODULE.brd]
2021-02-13 basic PPG module EAGLE schematic
    [NotSoSmartWatch-BASIC-PPG-MODULE.sch]
2021-02-20 updated top EAGLE schematic through Take 001
    [NotSoSmartWatch-BASIC-TOP.sch]
2021-02-20 updated top EAGLE board through Take 001
    [NotSoSmartWatch-BASIC-TOP.brd]
2021-02-22 updated bottom EAGLE schematic through Take 001
    [NotSoSmartWatch-BASIC-BOTTOM.sch]
2021-02-22 updated bottom EAGLE board through Take 001
    [NotSoSmartWatch-BASIC-BOTTOM.brd]
2021-02-27 updated partially through Take 003
    [NotSoSmartWatch-BASIC-BOTTOM.sch]
2021-02-27 updated through Take 002
    [NotSoSmartWatch-BASIC-TOP.sch]
2021-02-28 still working through Take 003
    [NotSoSmartWatch-BASIC-BOTTOM.sch]
2021-02-28 updated through Take 003 - worried I might have isolated polygon
    [NotSoSmartWatch-BASIC-BOTTOM.sch]
2021-02-28 updated through Take 003
    [NotSoSmartWatch-BASIC-TOP.sch]
2021-03-06 updated through Take 005
    [NotSoSmartWatch-BASIC-TOP.sch]
2021-03-13 updated through Take 006
    [NotSoSmartWatch-BASIC-TOP-version2.brd]
2021-03-13 almost done with Take 007
    [NotSoSmartWatch-BASIC-TOP-version2.sch]
2021-03-14 updated through Take 007
    [NotSoSmartWatch-BASIC-TOP-version2.sch]
2021-03-14 updated through Take 007 - not sure if I have an isolated polygon
    [NotSoSmartWatch-BASIC-TOP-version2.brd]
2021-03-15 updated through Take 008
    [NotSoSmartWatch-BASIC-TOP-version2.sch]
2021-03-15 updated through Take 008 - there's some airwires I don't understand, might be polygon related
    [NotSoSmartWatch-BASIC-TOP-version2.brd]
2021-03-15 updated through Take 008 - one airwire I don't understand, hopefully no polygon issues but not sure, drill clearance??:
    [NotSoSmartWatch-BASIC-BOTTOM-version2.brd]
2021-03-20 copied from KickJr Github repo
    [NotSoSmartWatch-BASIC-PPG-MODULE-BOM.xlsx]
2021-03-20 fixed ground connections on buttons - should be good now
    [NotSoSmartWatch-BASIC-TOP-version2.sch]
2021-03-20 fixed isolated polygon - should be good now
    [NotSoSmartWatch-BASIC-TOP-version2.brd]
2021-03-30 built from exhaustive BOM
    [NotSoSmartWatch-BASIC-TOP-BOM.xlsx]
2021-04-08 updated bottom board BOM - still unsure about op amps
    [NotSoSmartWatch-BASIC-BOTTOM-BOM.xlsx]
2021-04-17 I think BOM is complete
    [NotSoSmartWatch-BASIC-TOP-BOM.xlsx]
